claudiusmarius/MECHANICAL-TV-SIMPLE-TEST-GENERATOR-DFTA206/ListeComposantsDFTA206.png

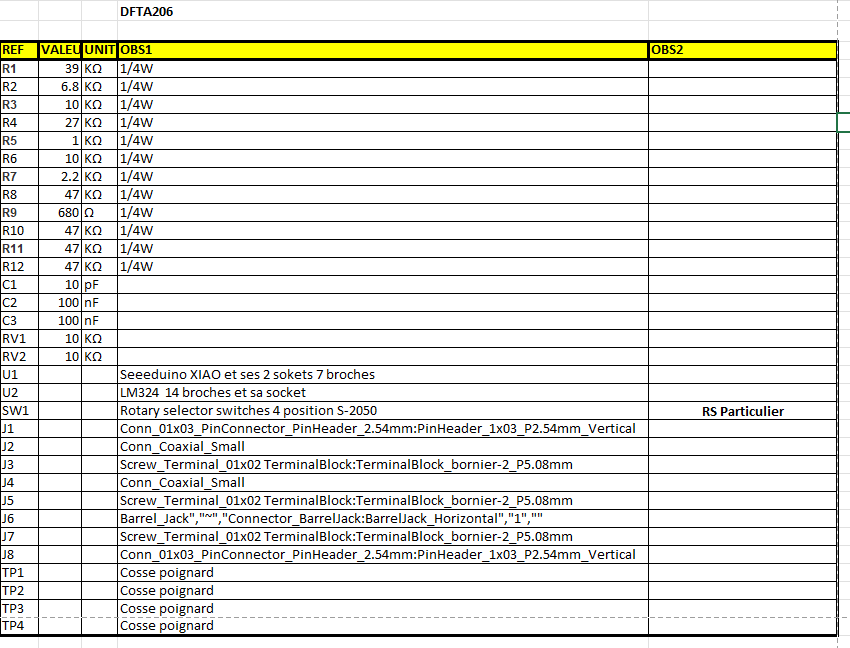
ListeComposantsDFTA206.png
