claudiusmarius/MECHANICAL-TV-SIMPLE-TEST-GENERATOR-DFTA206/Photo1PCBDFTA206.png

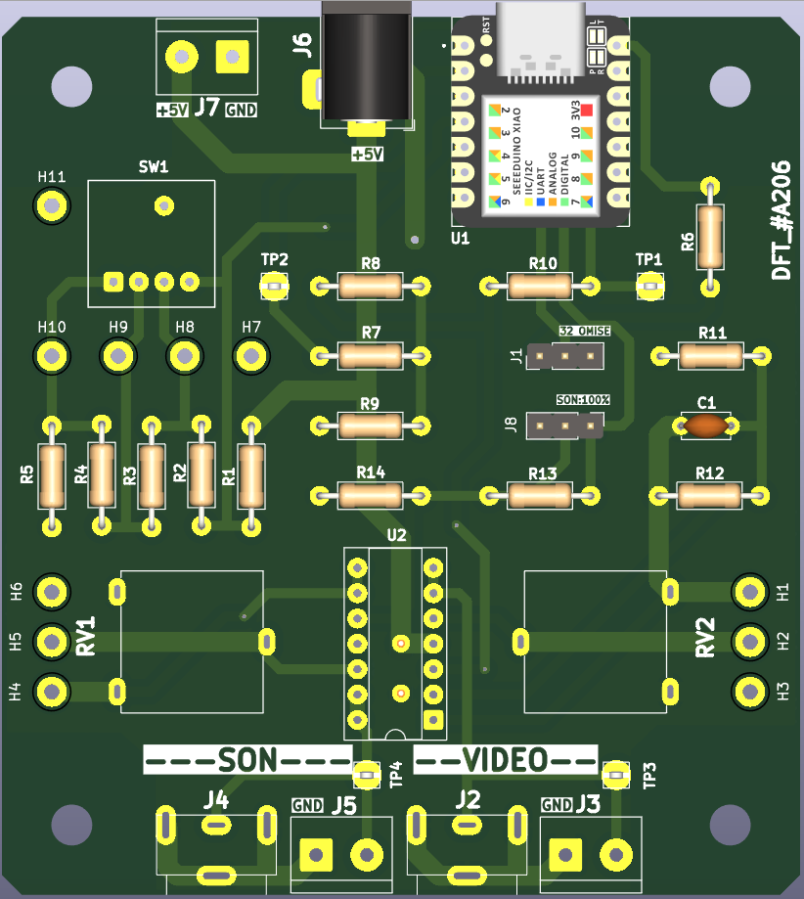
Photo1PCBDFTA206.png
