claudiusmarius/MECHANICAL-TV-SIMPLE-TEST-GENERATOR-DFTA206/Photo2PCBDFTA206.png

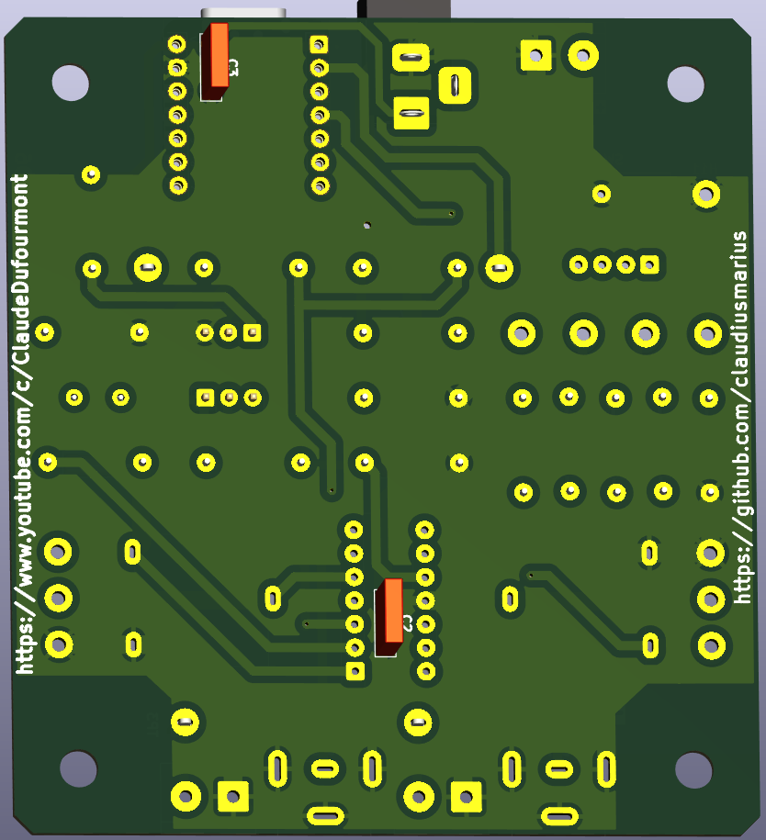
Photo2PCBDFTA206.png
