claudiusmarius/MECHANICAL-TV-SIMPLE-TEST-GENERATOR-DFTA206/ListeComposantsDFTA206.xlsx

 |  |  | DFTA206
REF | VALEUR | UNITE | OBS1 | OBS2
R1 | 39 | KΩ | 1/4W
R2 | 6.8 | KΩ | 1/4W
R3 | 10 | KΩ | 1/4W
R4 | 27 | KΩ | 1/4W
R5 | 1 | KΩ | 1/4W
R6 | 10 | KΩ | 1/4W
R7 | 2.2 | KΩ | 1/4W
R8 | 47 | KΩ | 1/4W
R9 | 680 | Ω | 1/4W
R10 | 47 | KΩ | 1/4W
R11 | 47 | KΩ | 1/4W
R12 | 47 | KΩ | 1/4W
C1 | 10 | pF
C2 | 100 | nF
C3 | 100 | nF
RV1 | 10 | KΩ
RV2 | 10 | KΩ
U1 |  |  | Seeeduino XIAO et ses 2 sokets 7 broches
U2 |  |  | LM324 14 broches et sa socket
SW1 |  |  | Rotary selector switches 4 position S-2050 | RS Particulier
J1 |  |  | Conn_01x03_PinConnector_PinHeader_2.54mm:PinHeader_1x03_P2.54mm_Vertical
J2 |  |  | Conn_Coaxial_Small
J3 |  |  | Screw_Terminal_01x02 TerminalBlock:TerminalBlock_bornier-2_P5.08mm
J4 |  |  | Conn_Coaxial_Small
J5 |  |  | Screw_Terminal_01x02 TerminalBlock:TerminalBlock_bornier-2_P5.08mm
J6 |  |  | Barrel_Jack","~","Connector_BarrelJack:BarrelJack_Horizontal","1",""
J7 |  |  | Screw_Terminal_01x02 TerminalBlock:TerminalBlock_bornier-2_P5.08mm
J8 |  |  | Conn_01x03_PinConnector_PinHeader_2.54mm:PinHeader_1x03_P2.54mm_Vertical
TP1 |  |  | Cosse poignard
TP2 |  |  | Cosse poignard
TP3 |  |  | Cosse poignard
TP4 |  |  | Cosse poignard
