claudiusmarius/MECHANICAL-TV-SIMPLE-TEST-GENERATOR-DFTA206/Schema MireTVDFTA206.pdf

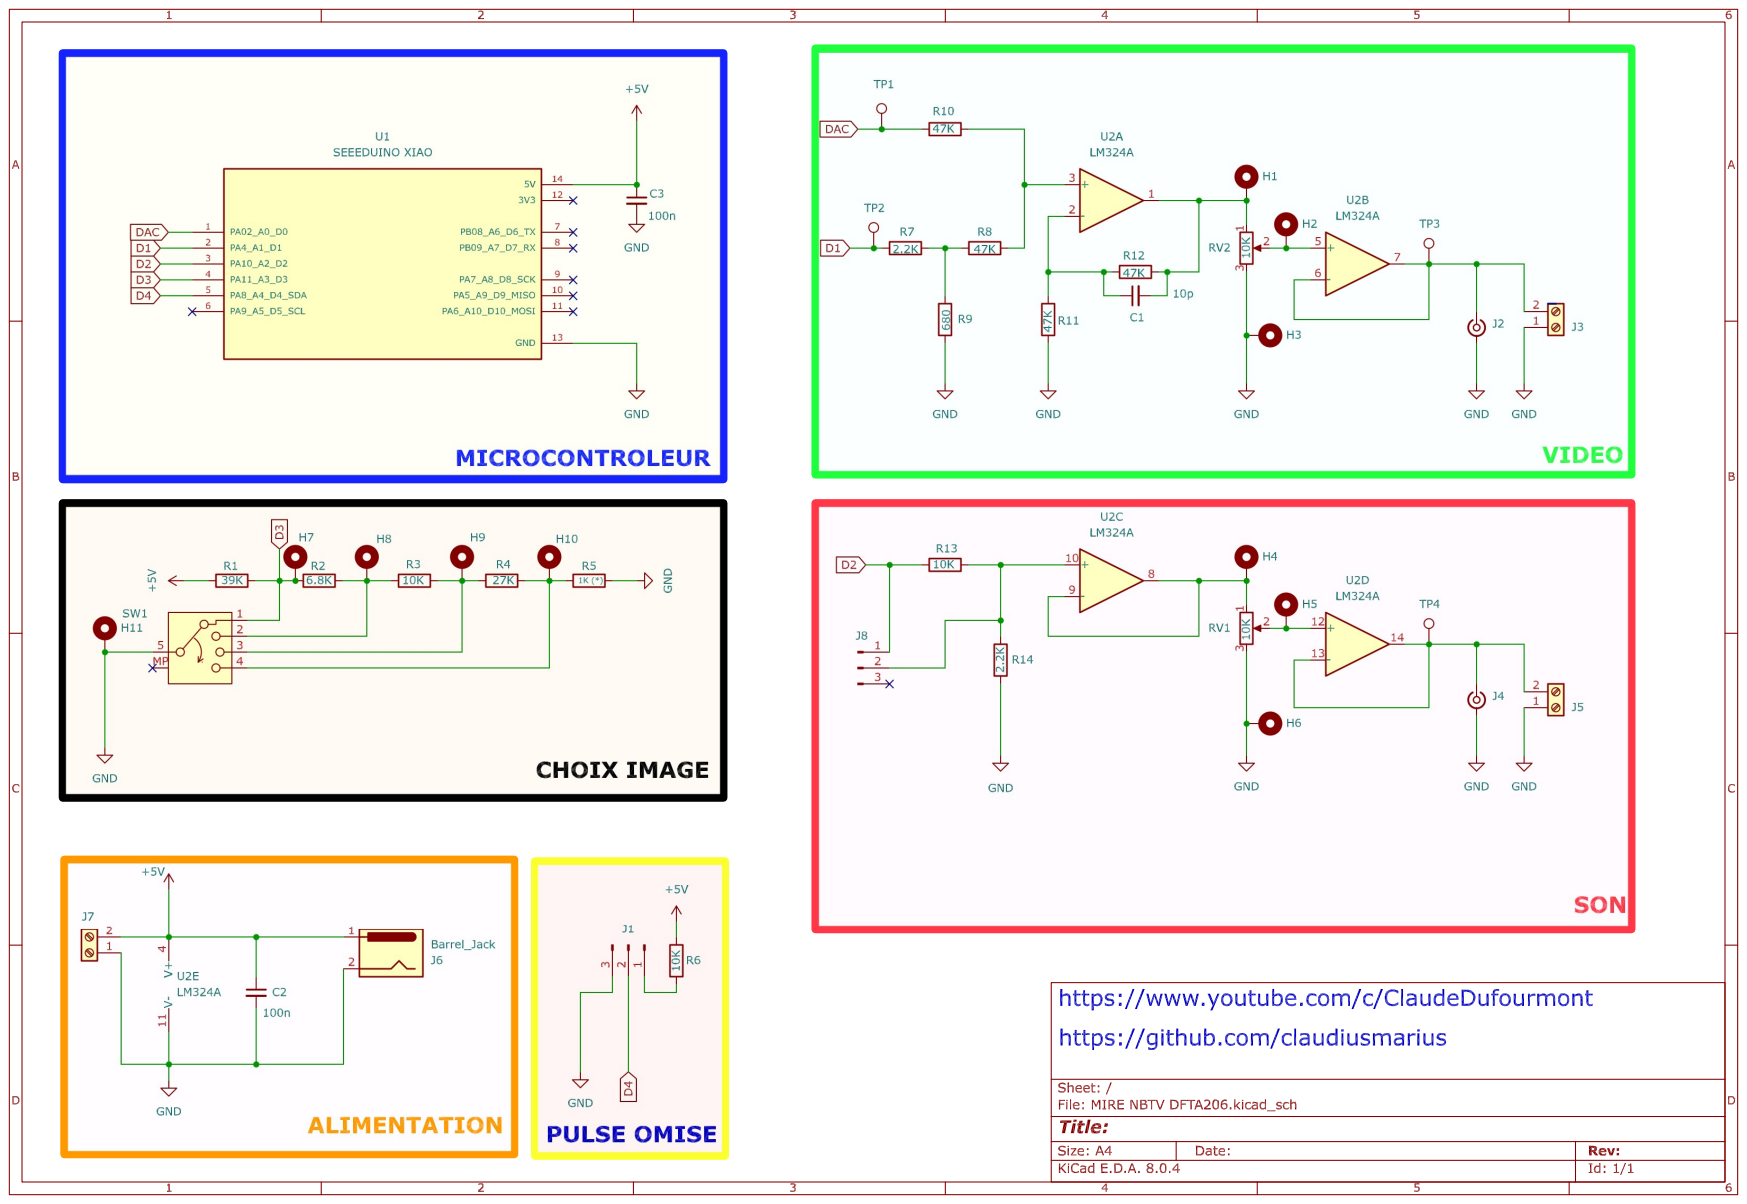
[picture p4: page 1]
